elchusco/das-sas-3d-box/docs/components/ruthex-kit-contenu.jpg

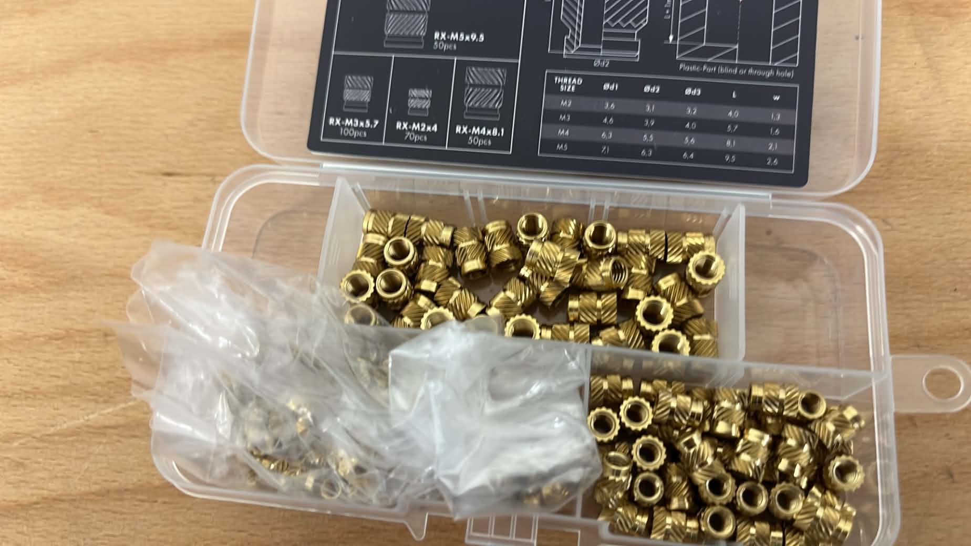
docs/components/ruthex-kit-contenu.jpg
