elchusco/das-sas-3d-box/docs/components/add2psu_dkey_70x30mm.jpg

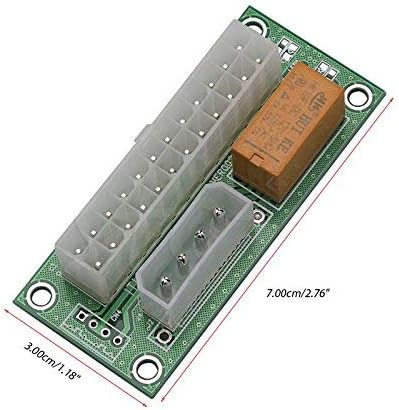
docs/components/add2psu_dkey_70x30mm.jpg
