elchusco/das-sas-3d-box/renders/bottom_v24.png

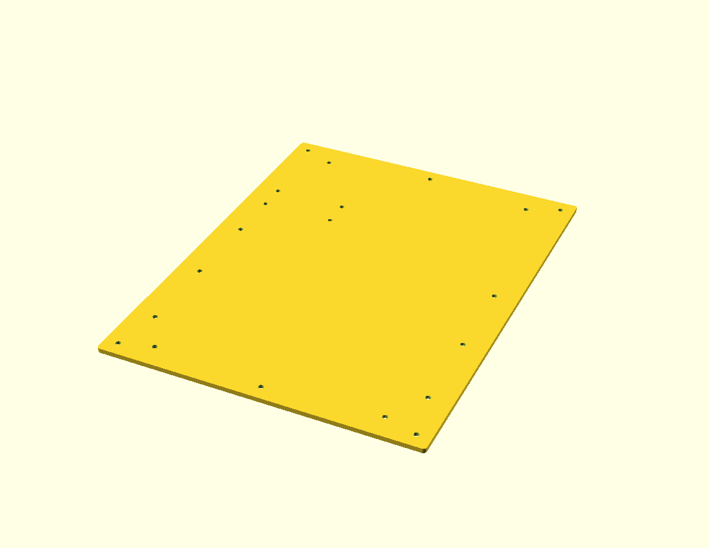
renders/bottom_v24.png
