elchusco/das-sas-3d-box/renders/corner_post_v23.png

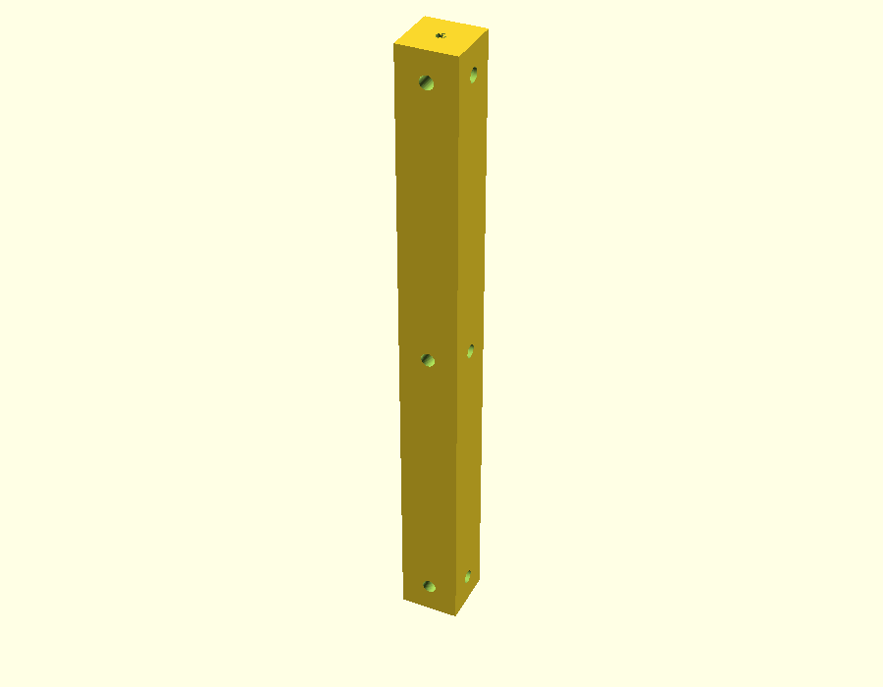
renders/corner_post_v23.png
