elchusco/das-sas-3d-box/renders/exploded_v24.png

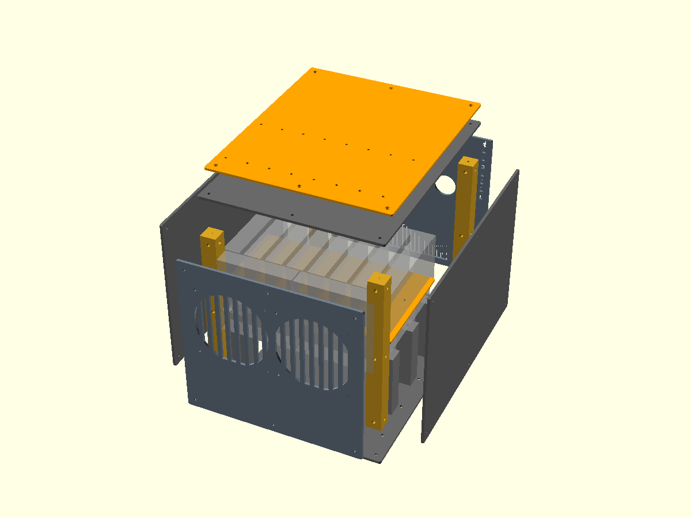
renders/exploded_v24.png
