elchusco/das-sas-3d-box/renders/fan_guard_v24.png

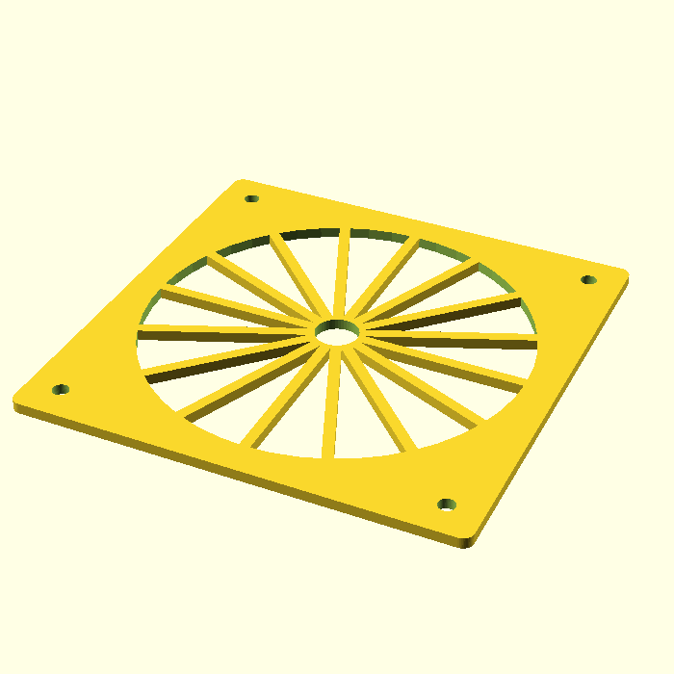
renders/fan_guard_v24.png
