elchusco/das-sas-3d-box/renders/front_v2.png

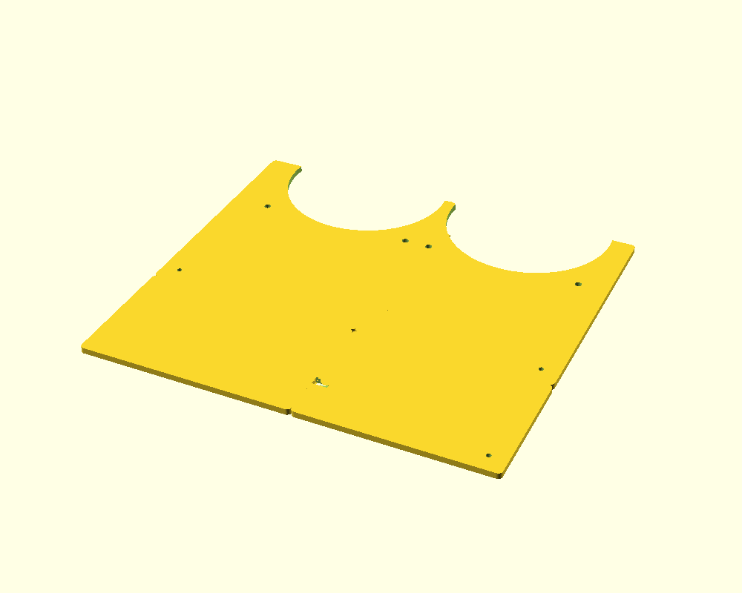
renders/front_v2.png
