elchusco/das-sas-3d-box/renders/front_v25.png

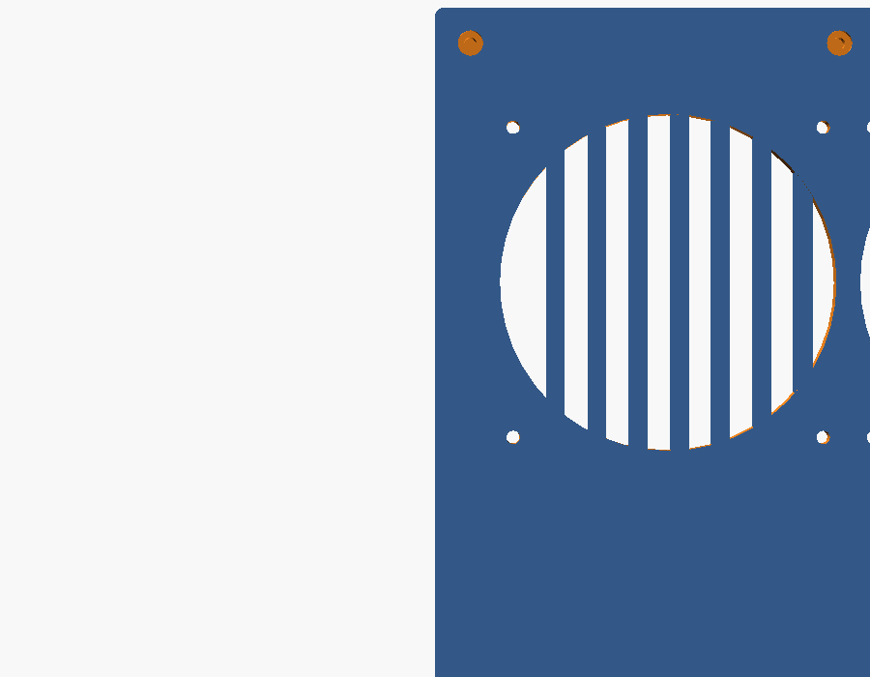
renders/front_v25.png
