elchusco/das-sas-3d-box/renders/lid_v2.png

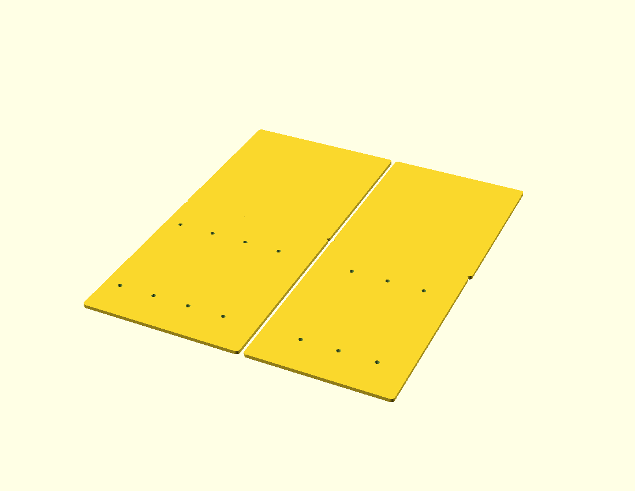
renders/lid_v2.png
