elchusco/das-sas-3d-box/renders/lid_v25.png

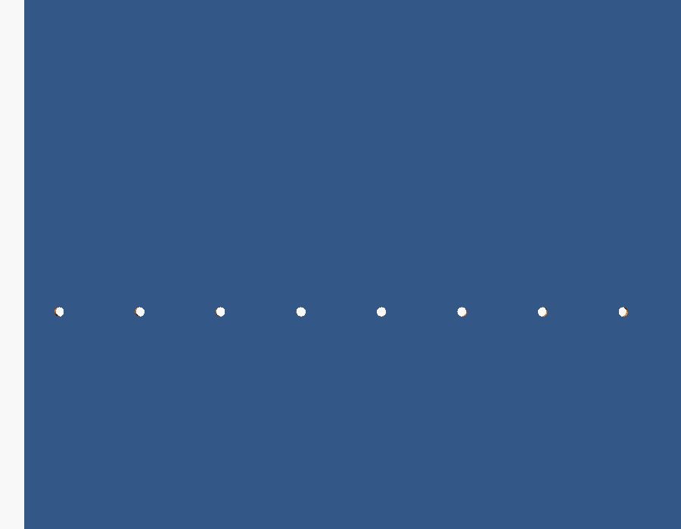
renders/lid_v25.png
