elchusco/das-sas-3d-box/renders/rear_v2.png

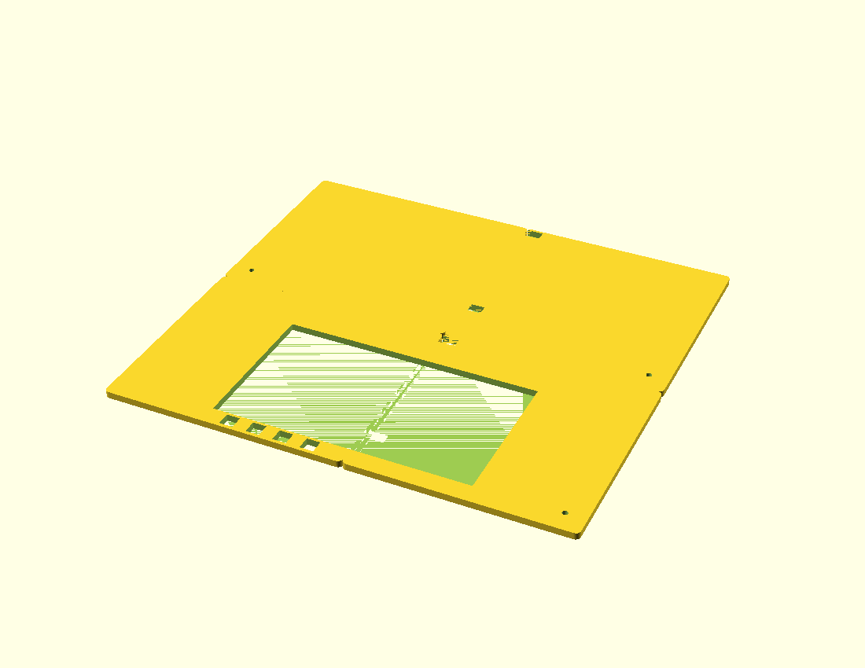
renders/rear_v2.png
