elchusco/das-sas-3d-box/renders/rear_v23.png

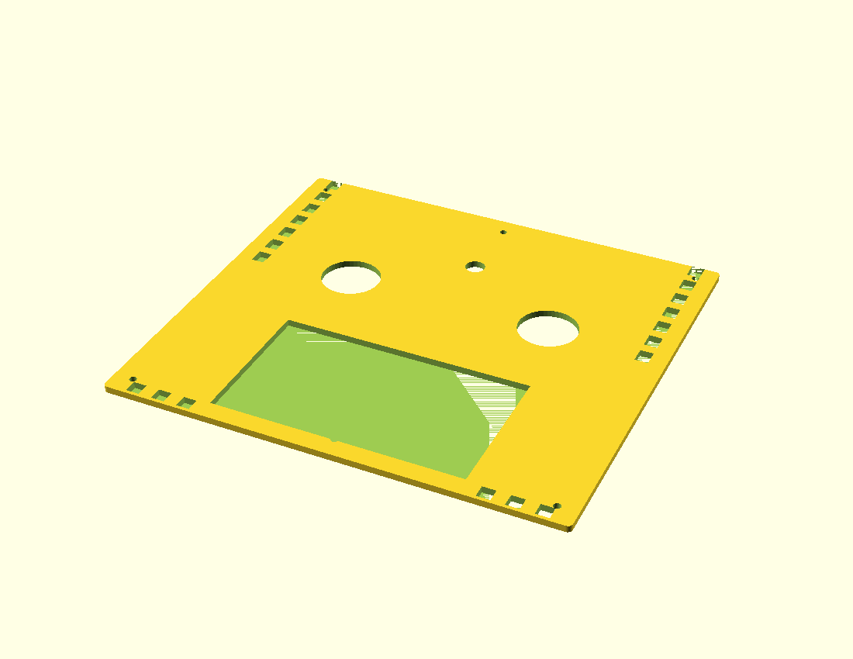
renders/rear_v23.png
