elchusco/das-sas-3d-box/renders/rear_v25.png

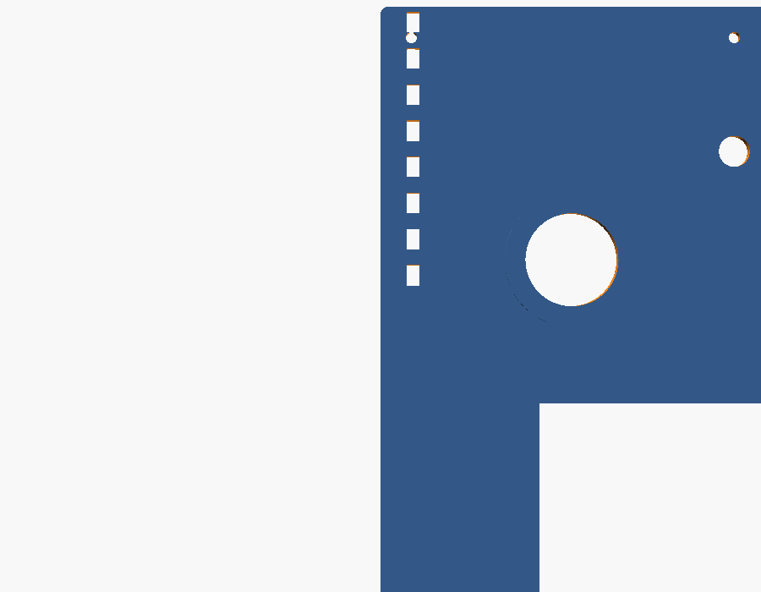
renders/rear_v25.png
