elchusco/das-sas-3d-box/docs/components/inserts-ruthex.md

# Inserts Ruthex — assemblage des panneaux

Kit utilisé : **Ruthex GE-KASTEN-001**
(photos : `ruthex-kit-dimensions.jpg` — étiquette cotes, `ruthex-kit-contenu.jpg` — contenu du kit).

| Réf | Dimensions (⌀d1 ext. / ⌀d2 / L / min. w) | Stock kit | Usage dans le projet |
|---|---|---|---|
| **RX-M4×8.1** | ⌀6.3 / 5.5 / 5.6, L 8.1, collet 2.1 | 50 pcs | poteaux/jetées (24×24), struts |
| **RX-M3×5.7** | ⌀4.6 / 3.9 / 4.0, L 5.7, collet 1.6 | 100 pcs | lid, supports fins (Add2PSU, fan guards) |
| RX-M5×9.5 | ⌀7.1 / 6.3 / 6.4 | 50 pcs | (réserve) |
| RX-M2×4 | ⌀3.6 / 3.1 / 3.2 | 70 pcs | (réserve) |

## Règles de perçage (données Ruthex)

- Trou plastique : **⌀d3** (M3 → 4.0, M4 → 5.6), profondeur **L + 1 mm** minimum.
- L'insert se pose **à chaud** (fer à souder ou pistolet à insert, ~200 °C),
  collet affleurant la surface.
- Jamais d'insert dans une paroi < L : les M4×8.1 vont uniquement dans les
  **poteaux et bosses ≥ 9 mm**, jamais à plat dans un panneau de 4 mm.

## Plan d'affectation

| Assemblage | Insert | Vis |
|---|---|---|
| Jetées d'angle ↔ panneaux (avant/arrière/côtés) | M4×8.1 dans les poteaux | M4 × 12 |
| Jetées ↔ fond / plafond | M4×8.1 en tête de poteau | M4 × 12 |
| Poteaux cage (struts) ↔ étagère | M3×5.7 | M3 × 12 |
| Add2PSU ↔ fond | M3×5.7 ×4 | M3 × 6 |
| fan guards (si vissées) | M3×5.7 ×8 | M3 × 8 |

## ⚠️ Exception : les disques

Les trous des HDD sont au standard **6-32 UNC (impérial)** : ni M3 ni M4 ne
s'y visse. Les 16 vis de disques sont donc des **6-32 × 1/4"** directes dans
le plastique du lid (3.2 mm, engagement 3.15 mm — conforme SFF-8301,
pénétration max 3.56). Pas d'insert.
