elchusco/das-sas-3d-box/docs/components/ruthex-kit-dimensions.jpg

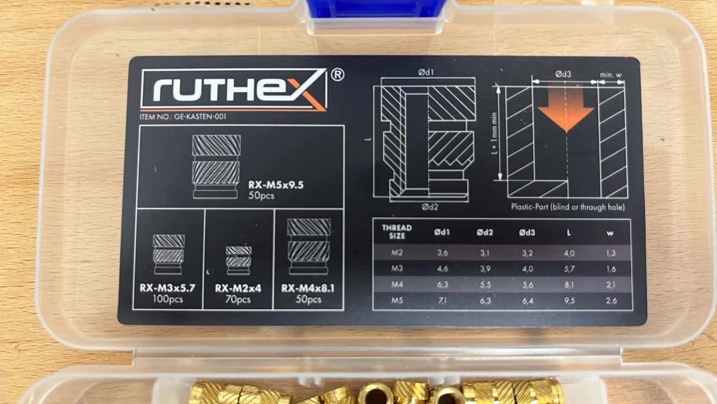
docs/components/ruthex-kit-dimensions.jpg
