elchusco/das-sas-3d-box/stl/corner_post.stl

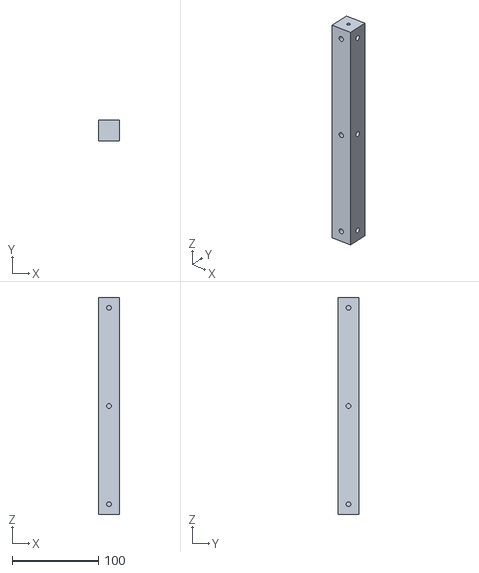
[picture p15: CAD file, 2026-11-01]
stl/corner_post.stl
24.0 x 24.0 x 252.0
