elchusco/das-sas-3d-box/stl/top.stl

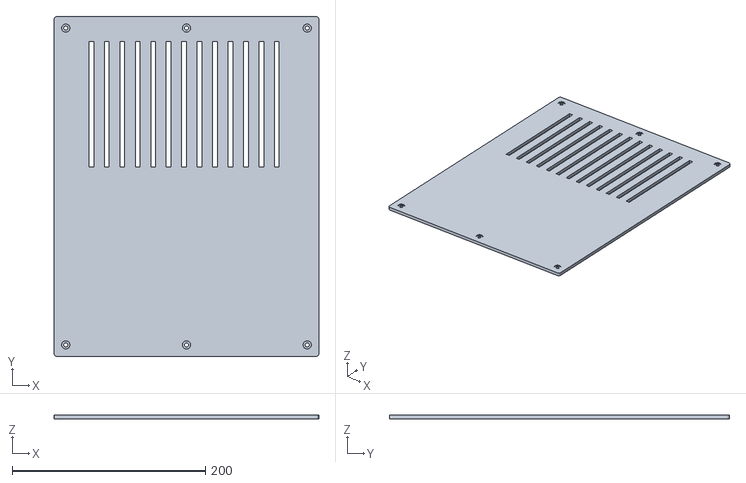
[picture p16: CAD file, 2026-11-01]
stl/top.stl
274.0 x 352.0 x 4.00
