elchusco/das-sas-3d-box/stl/front.stl

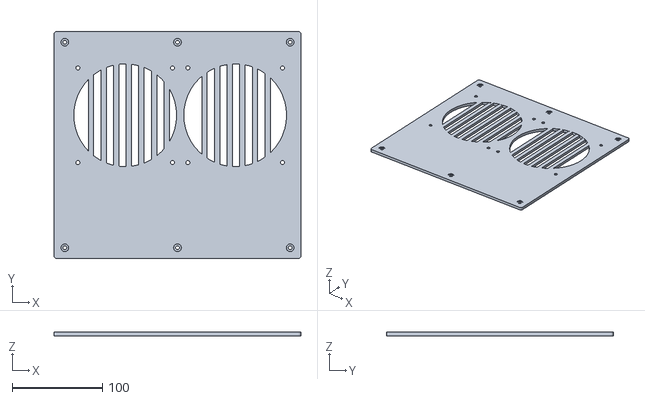
[picture p17: CAD file, 2026-11-01]
stl/front.stl
274.0 x 252.0 x 4.00
