elchusco/das-sas-3d-box/stl/rear.stl

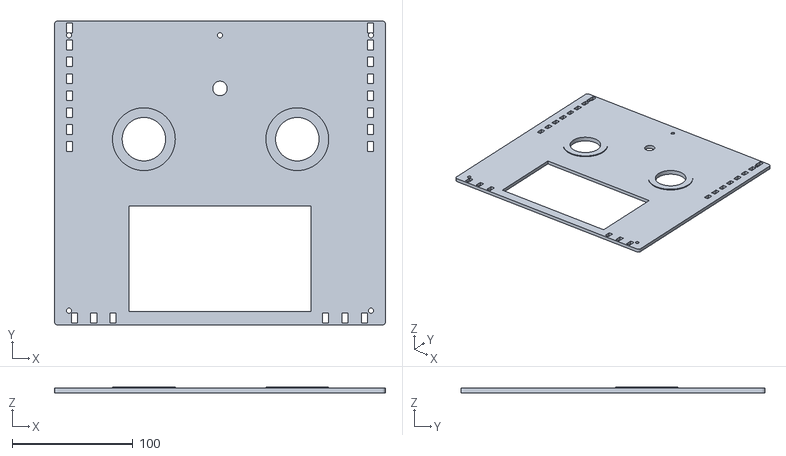
[picture p18: CAD file, 2026-11-01]
stl/rear.stl
274.0 x 252.0 x 5.00
