elchusco/das-sas-3d-box/stl/left.stl

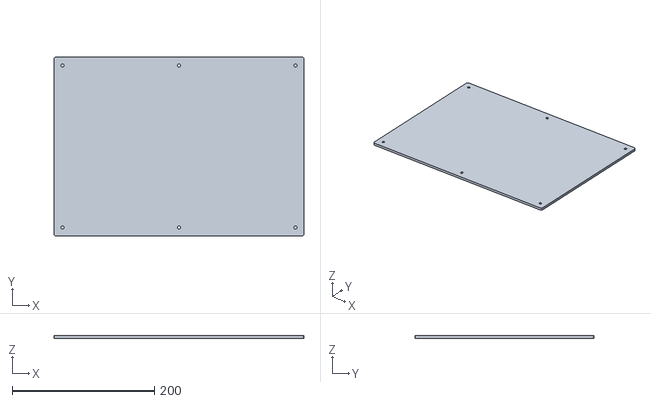
[picture p19: CAD file, 2026-11-01]
stl/left.stl
352.0 x 252.0 x 4.00
