elchusco/das-sas-3d-box/stl/shelf.stl

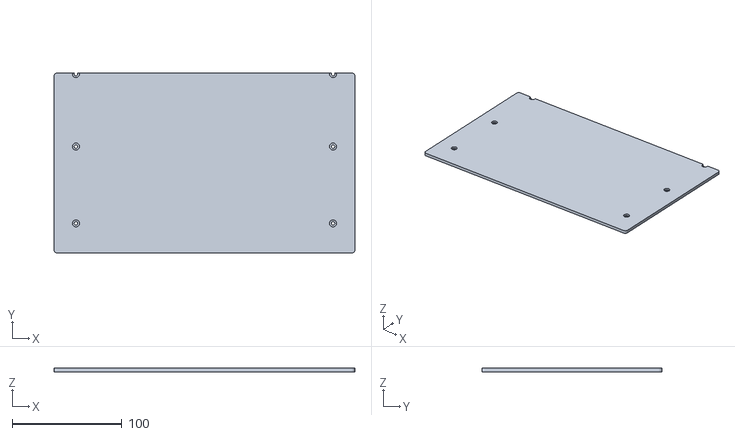
[picture p20: CAD file, 2026-11-01]
stl/shelf.stl
274.0 x 164.0 x 3.20
