elchusco/das-sas-3d-box/stl/fan_guard.stl

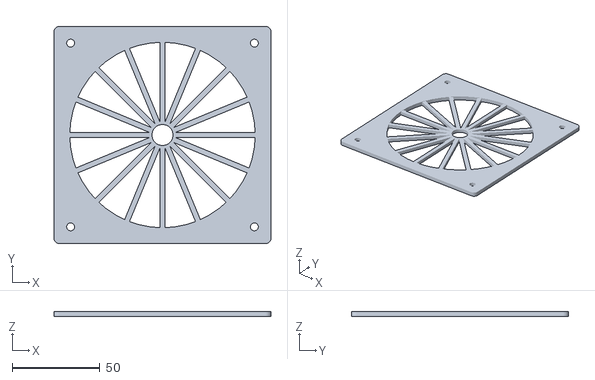
[picture p21: CAD file, 2026-11-01]
stl/fan_guard.stl
124.0 x 124.0 x 3.00
