elchusco/das-sas-3d-box/stl/strut.stl

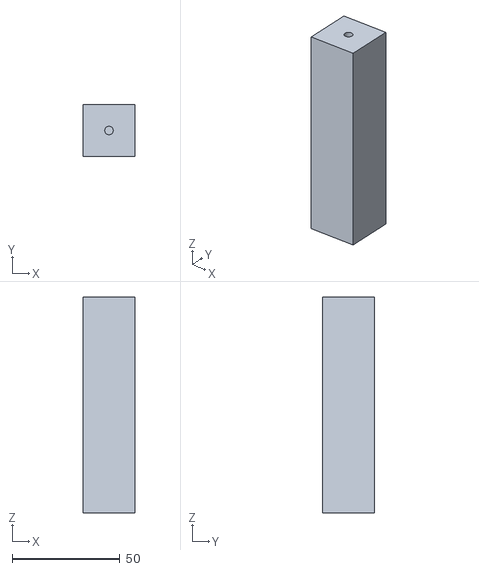
[picture p22: CAD file, 2026-11-01]
stl/strut.stl
24.0 x 24.0 x 100.0
