elchusco/das-sas-3d-box/stl/lid.stl

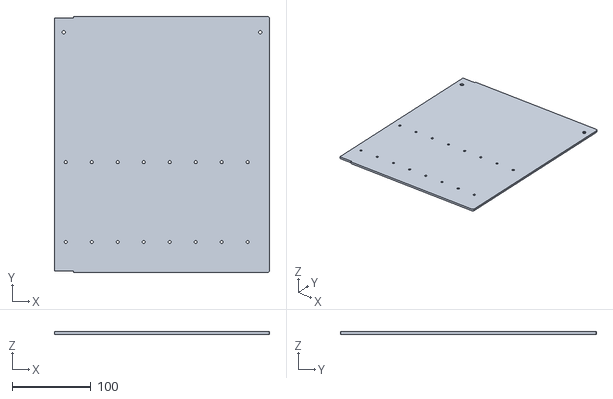
[picture p23: CAD file, 2026-11-01]
stl/lid.stl
274.0 x 326.0 x 3.20
