elchusco/das-sas-3d-box/stl/atx_bridge.stl

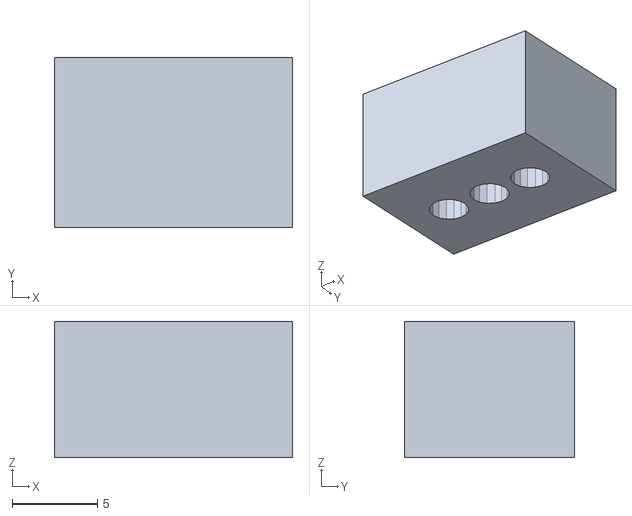
[picture p24: CAD file, 2026-11-01]
stl/atx_bridge.stl
14.0 x 10.0 x 8.00
