elchusco/das-sas-3d-box/stl/box_foot.stl

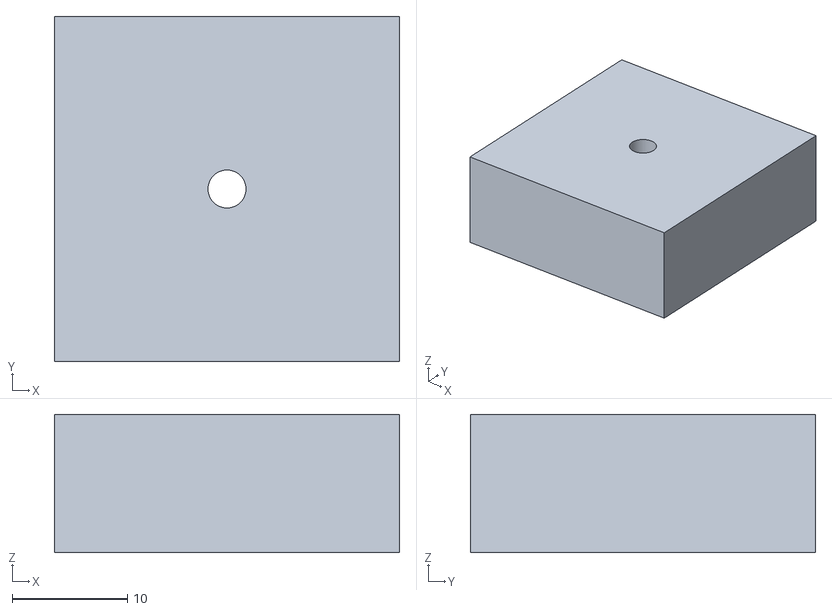
[picture p25: CAD file, 2026-11-01]
stl/box_foot.stl
30.0 x 30.0 x 12.0
