elchusco/das-sas-3d-box/(list of files, cad)

Other CAD files:
stl/right.stl
stl/bottom.stl
