elchusco/das-sas-3d-box/renders/assembly_v1.png

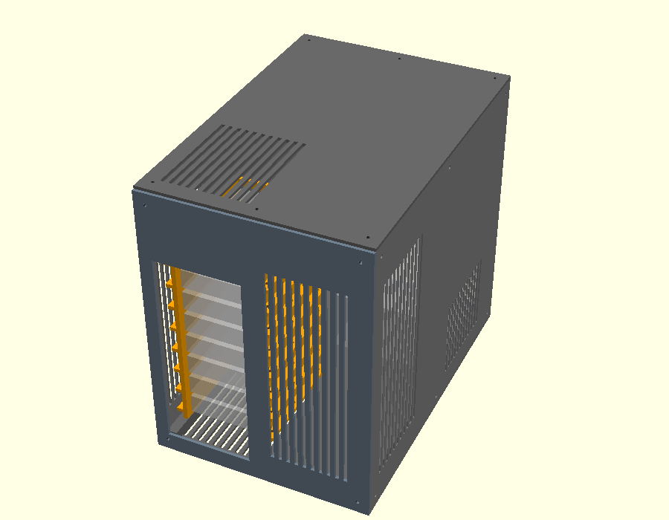
renders/assembly_v1.png
