elchusco/das-sas-3d-box/renders/assembly_v2.png

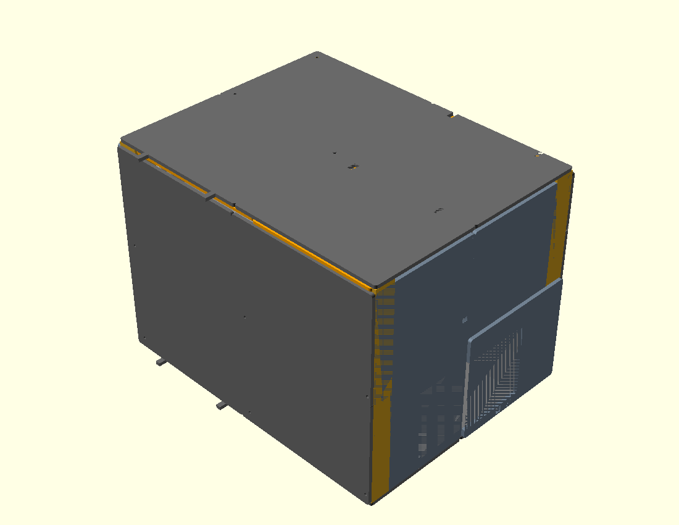
renders/assembly_v2.png
