elchusco/das-sas-3d-box/renders/assembly_v23.png

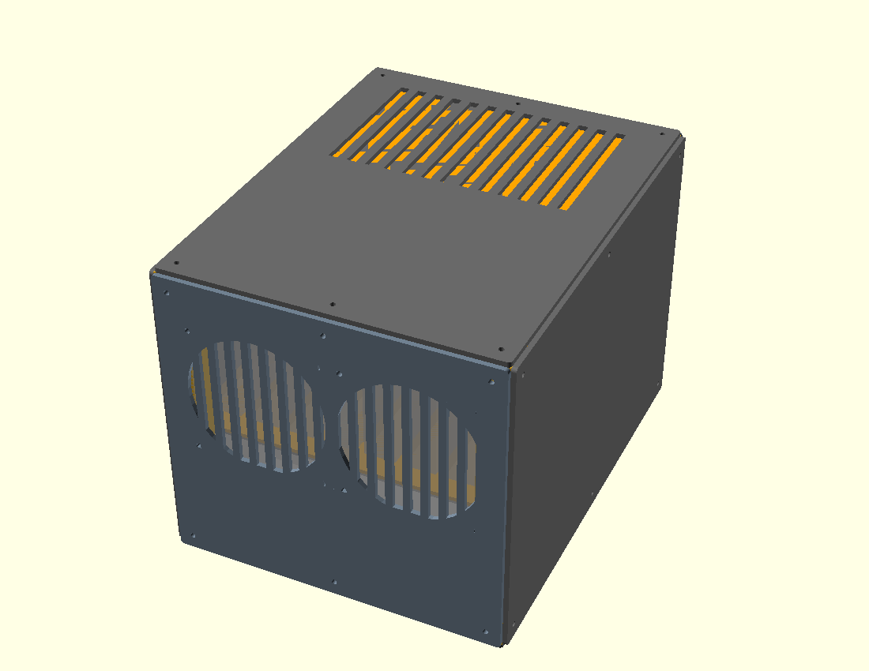
renders/assembly_v23.png
