elchusco/das-sas-3d-box/renders/assembly_v25.png

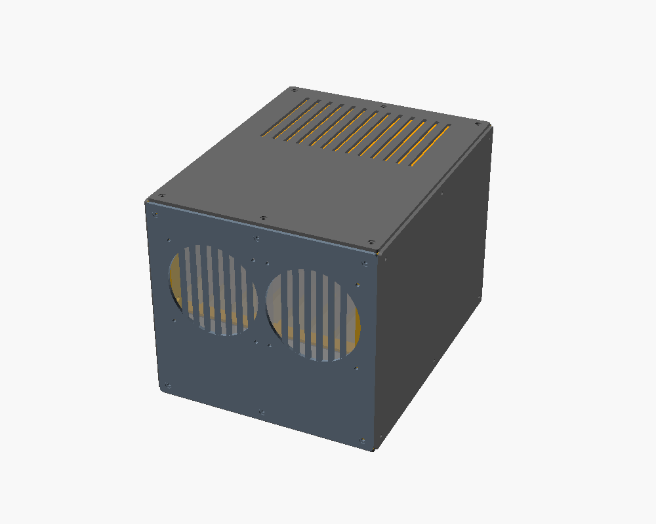
renders/assembly_v25.png
