elchusco/das-sas-3d-box/(commit log)

2026-10-19 Boîtier DAS 8x SAS 3.5" + CX430 : v2 (disques sur tranche), audit v1, docs
    - scad/boitier_8_sas_v2.scad : refonte disques sur tranche, 2 fans 120 push,
    PSU arrière-bas, segmentation plateau 220, conformité SFF-8301 (trous
    latéraux 28.50/130.10 à 6.35 de la face PCB, vis 6-32, lid 3.2)
    - docs/audit-v1.md : 6 défauts bloquants de la v1 (conflit fan/PSU, rails
    désalignés, pattern de vis erroné, pas de PS_ON…)
    - docs/conformite.md : tableau besoin ↔ mesure ↔ source ↔ statut
    - TODO.md : points à fignoler avant impression
    - renders/ : rendus de contrôle (assembly, faces, lid)
    [boitier_8_sas_sata_atx_v1.scad, boitier_8_sas_v2.scad]
2026-10-19 v2.3 : panneaux monoblocs (plateau 1m²), inserts Ruthex, Add2PSU
    - SCAD : bed_max=1000 -> suppression totale de la segmentation (ergots/slots) ;
    poches inserts M4x8.1 (⌀5.6×9.1) dans les jetées d'angle, M3x5.7 dans les
    struts ; trous 6-32 disques conservés dans le lid
    - Add2PSU : support 4 trous ⌀3.2 (entraxe 64×24) au fond sous le PSU +
    passe-câble Molex ⌀12 au panneau arrière (démarrage auto du DAS avec la tour)
    - docs/components/ : fiche Add2PSU (réf Amazon 2pcs 15,19 €, ASIN B09R1LTX52)
    + photo produit + fiche inserts Ruthex (table de perçages officielle)
    - docs : README/conformite/TODO mis à jour (report #R1-R6, ajout vérifs
    physiques Add2PSU/Molex)
    [boitier_8_sas_v2.scad]
2026-10-19 v2.4 : finitions TODO (fraisages, pieds, grilles fines, fan_guard, exploded, STL)
    - #1 struts/étagère : lumière M3.2 + fraisage tête côté dessous de l'étagère,
    insert M3 en tête de strut, vis M4 fond->strut traversante
    - #7 pieds : 4 trous M4 fraisés au fond (x 40/230, y 16/332)
    - #8 fraisage ⌀8.6 côté extérieur sur tous les trous M4 de panneaux + lid
    - #4 grilles arrière : fentes fines 5x8 (extraction + air PSU)
    - #5 suppression des encoches d'air de l'étagère (étanchéité du flux)
    - #6 show_ghosts=true paramétrable (pièces seules sans superposition)
    - #R2 fan_guard recentré (124x124), 16 rayons, trous M4 carré 105
    - #R3 part="exploded" (amplitude explode=60) + exp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
    [boitier_8_sas_v2.scad]
2026-11-01 v2.4 : docs à jour, STL commités, photos Ruthex renommées
    - stl/ : les 13 STL de référence sont commités (.gitignore n'exclut plus stl/)
    - README : table d'état et arborescence alignées sur v2.4
    - SCAD : en-tête bumpé en v2.4
    - docs/components : photos Ruthex renommées (dimensions/contenu) et référencées
    dans inserts-ruthex.md
    [atx_bridge.stl, boitier_8_sas_v2.scad, bottom.stl, box_foot.stl, corner_post.stl, fan_guard.stl, front.stl, left.stl]
2026-11-01 v2.5 : anti z-fighting F5 + corrections géométrie
    - découpes débordantes 1 mm (rear PSU/fentes, top events, lid, bottom) :
    supprime le z-fighting de l'aperçu F5, géométrie finale inchangée
    - collerettes grommets saillantes 1 mm côté intérieur (renfort réel)
    - ghosts +0.3 mm là où les faces témoins touchaient les panneaux
    - grille avant recalée : fop en coords locales (bug +4 mm), barreaux
    enfoncés 0.2 mm, aucun barreau sur les colonnes de vis fans,
    traverses supprimées (noyées dans la matière)
    - strut : pilote M4 borgne (trou traversant avalait la poche M3),
    placement xx-12 (décalage 12 mm vs trous)
    - shelf : fraises M3 côté dessus (têtes affleurantes, disques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
    [boitier_8_sas_v2.scad, bottom.stl, corner_post.stl, fan_guard.stl, front.stl, left.stl, lid.stl, rear.stl]
2026-11-01 docs : audit v2.4→v2.5 (z-fighting + 8 bugs géométriques)
    - docs/audit-v24-flicker.md : cause du flicker (surfaces coplanaires,
    OpenCSG), tableau des correctifs anti z-fighting, 8 bugs détaillés
    (fop +4 mm, barreaux bouchant des vis, trou M4 rear, strut, fraises
    étagère, fraisages front/top, lid∩poteaux), validation (volumes,
    intersections)
    - README : lien vers l'audit dans le tableau d'état
    - TODO : ligne obsolete z-fighting résolu par v2.5
